JackMcCrae/AIS-SRAD-2026/FC Design/Datasheets/Processor/STM32 power scheme.png

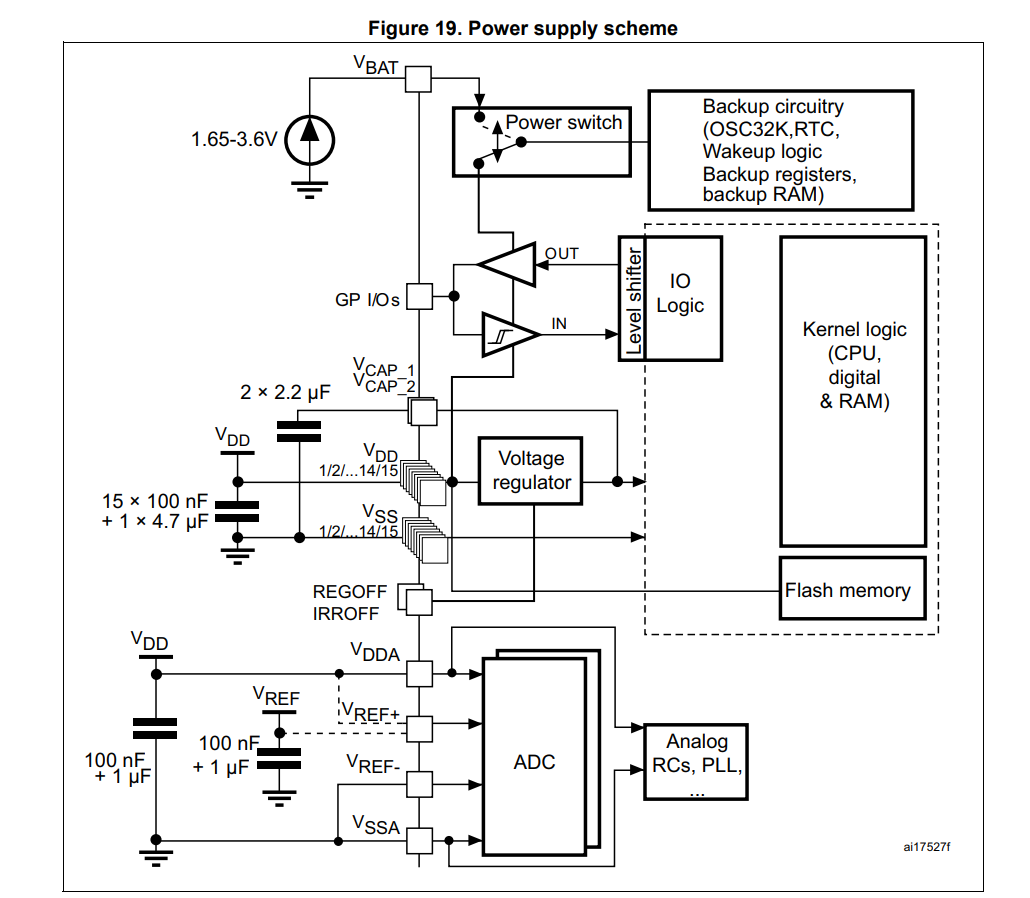
FC Design/Datasheets/Processor/STM32 power scheme.png
