JackMcCrae/AIS-SRAD-2026/FC Design/Manufacturing Files/BOM File/JLC BOM.xlsx

Component | Designator | Footprint
CY-9650 | BUZZER1 | MLT-9650
100nF | C1,C2,C4,C5,C6,C7,C8,C10,C14,C15,C16,C17,C23,C31 | GRM022C81C222KE01L
2.2uF | C18,C19 | GRM033D70J224ME01D
4.7uF | C20 | GRM033D70J224ME01D
1uF | C22,C28 | CAPC0603X33N
0603 Green 509-620mcd | LED1,LED2,LED3,LED4,LED5,LED6 | LED0603-RD
10KR | R9,R5,R3,R8,R7,R10,R11 | R_0201_0603Metric
5.1KR | R2 | R_0201_0603Metric
DMN2008LFU-7 | Q3,Q2 | DMN2008LFU7
Conn_01x08 | J6,J3 | Hirose_DF13-08P-1.25DSA_1x08_P1.25mm_Vertical
EBAA-02-C | J5,J4,J2 | EBAA02C
USB-310-B-SU | U7 | UBS-310-B-SU
STM32F205VGT | U3 | STM32F205VGT
MMBT3906-TP | Q1 | SOT95P237X125-3N
KC2520Z | U2 | Oscillator_SMD_Kyocera_KC2520Z-4Pin_2.5x2.0mm
AZ1117-3.3 | U4 | SOT-223-3_TabPin2
MS5607-02BA | U5 | LGA-8_3x5mm_P1.25mm
QMA6100P | U1 | QMA6100P
W25N01GVZEIG | U6 | W25N01GVZEIG
