JackMcCrae/AIS-SRAD-2026/FC Design/AIS IREC 2026 FC/AIS IREC 2026 FC.kicad_pcb

## KiCad design FC Design/AIS IREC 2026 FC/AIS IREC 2026 FC.kicad_pcb (2026-03-24)

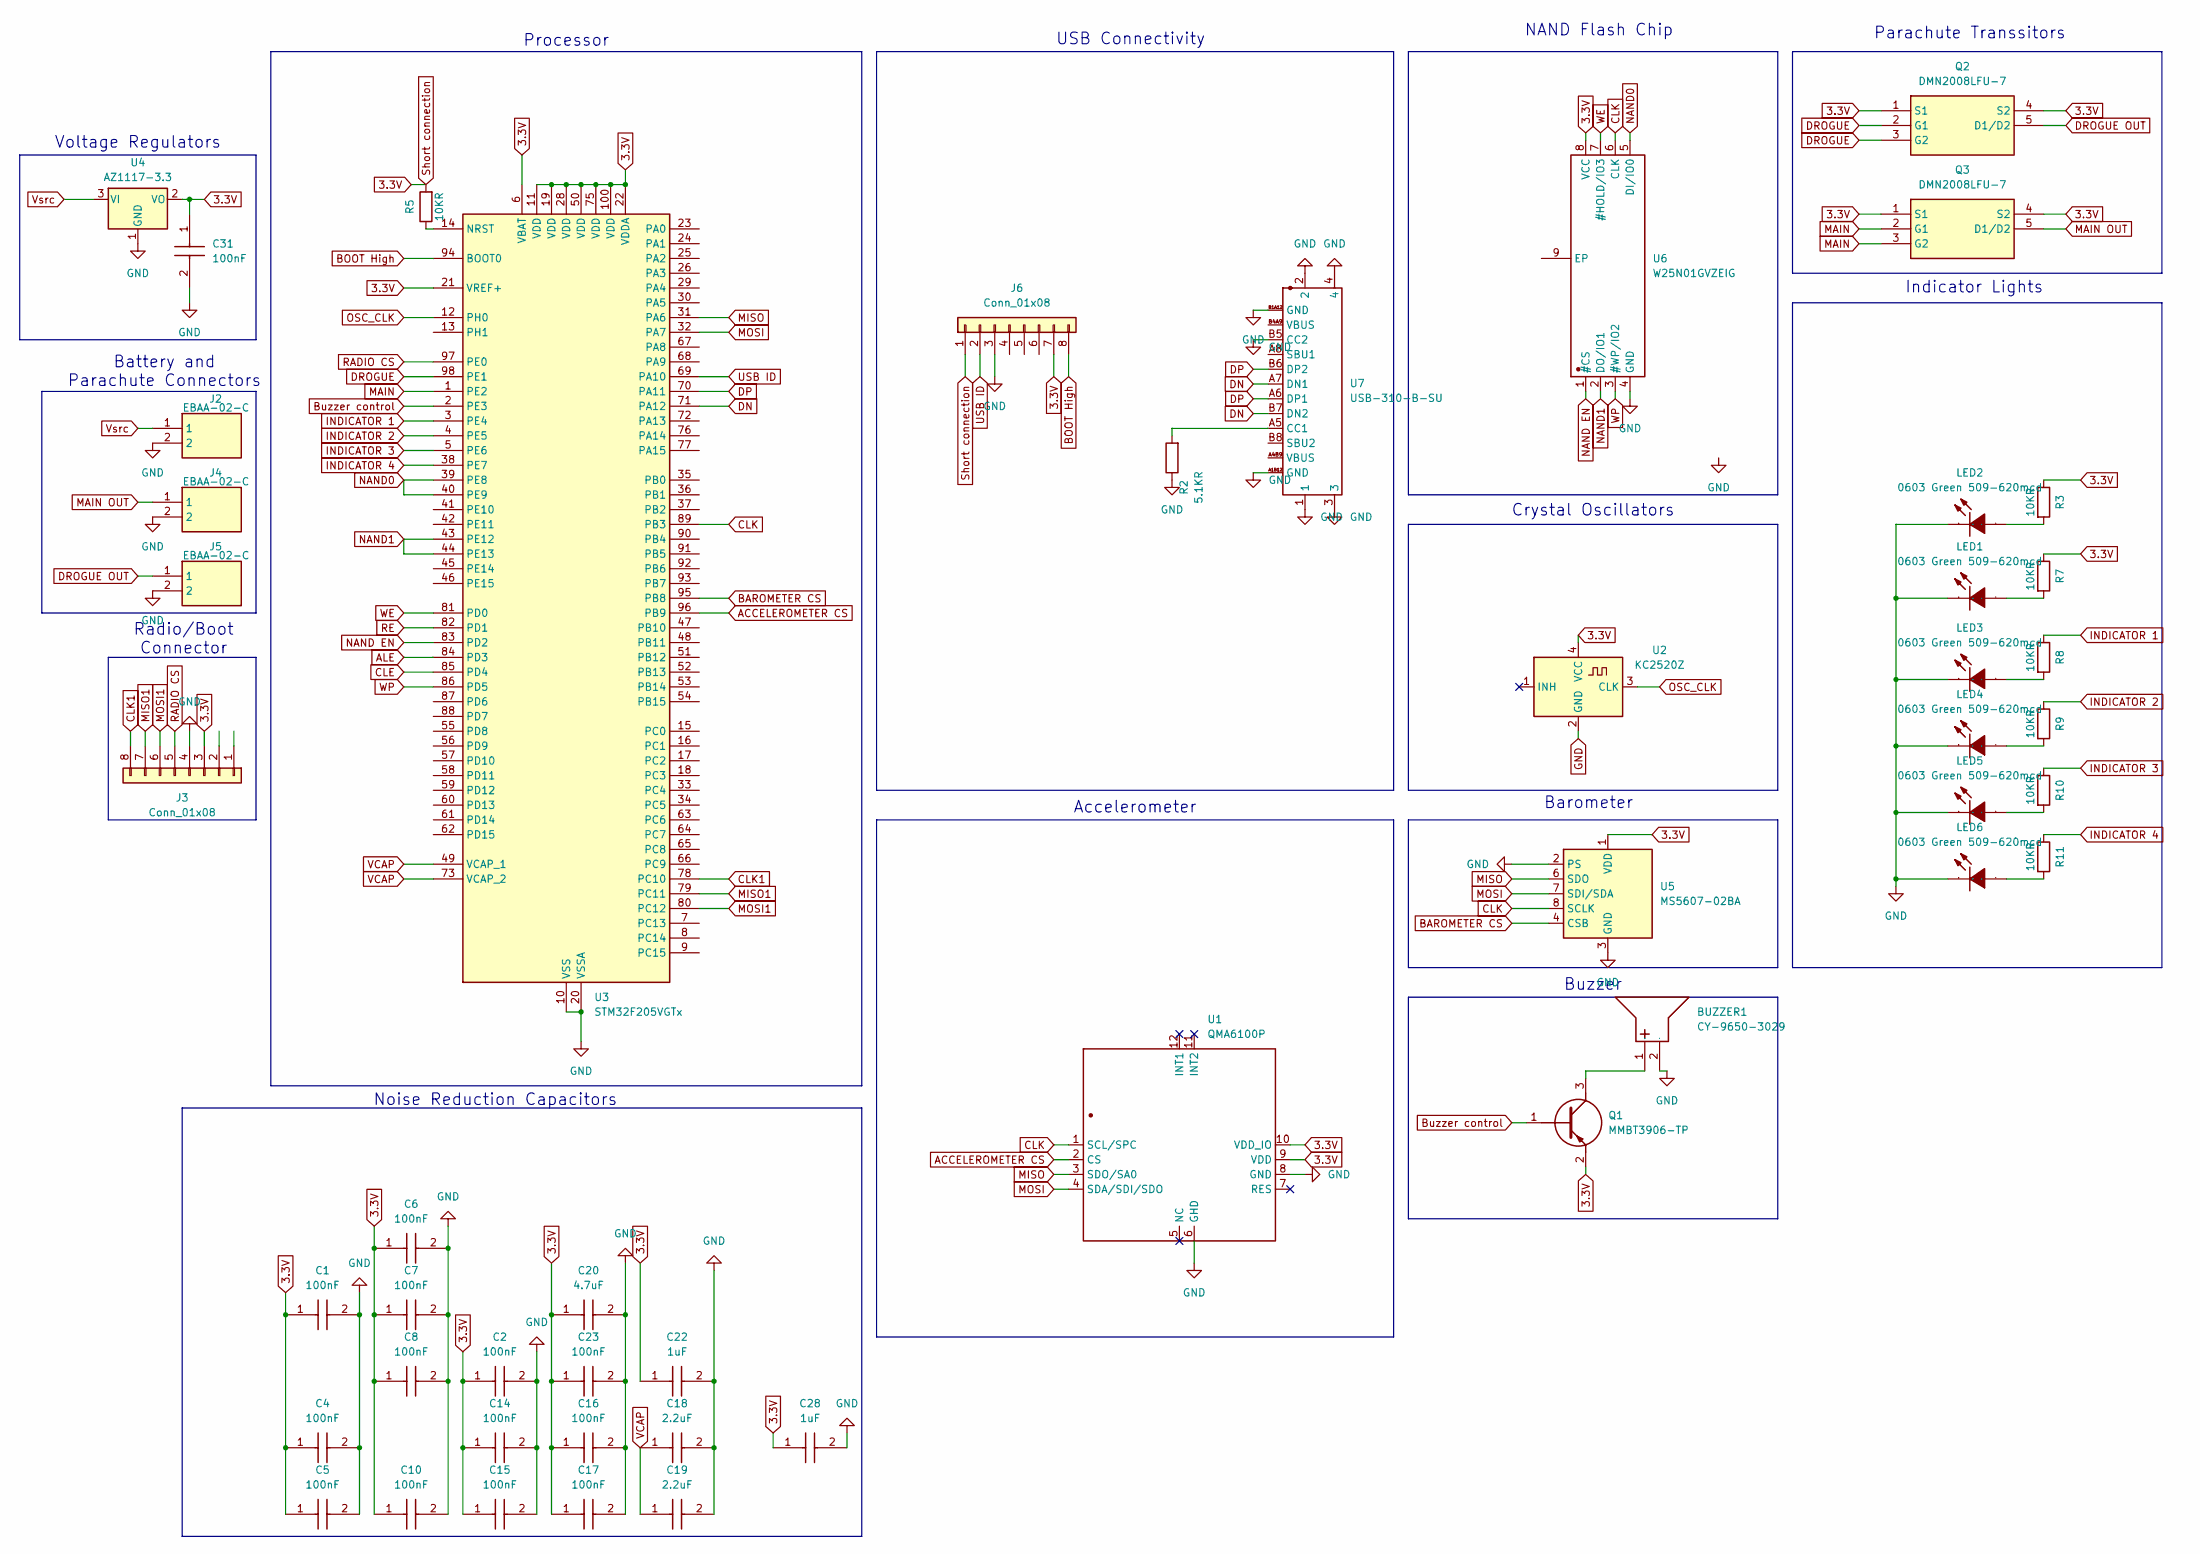
[picture p2: schematic AIS IREC 2026 FC.kicad_sch, AIS SRAD Flight Computer 2026]

Parts:
BUZZER1: CY-9650-3029; MLT-9650; Manufacturer Part Cy-9650-3029
C1, C2, C4, C5, C6, C7, C8, C10, C14, C15, C16, C17, C23, C31: 100nF; GRM022C81C222KE01L; Mouser Part Number 81-GRM022R61A104KE1L
C18, C19: 2.2uF; GRM033D70J224ME01D; Mouser Part Number 81-GRM033R61A225KE7D
C20: 4.7uF; GRM033D70J224ME01D; Mouser Part Number 81-GRM035R60J475ME5D
C22, C28: 1uF; CAPC0603X33N; Mouser Part Number 81-GRT033R60J105ME3D
J2, J4, J5: EBAA-02-C; EBAA02C; Mouser Part Number 737-EBAA-02-C
J3, J6: Conn_01x08; Hirose_DF13-08P-1.25DSA_1x08_P1.25mm_Vertical
LED1, LED2, LED3, LED4, LED5, LED6: 0603 Green 509-620mcd; LED0603-RD; Manufacturer Part KT-0603G
Q1: MMBT3906-TP; SOT95P237X125-3N; Mouser Part Number 833-MMBT3906-TP
Q2, Q3: DMN2008LFU-7; DMN2008LFU7; Mouser Part Number 621-DMN2008LFU-7
R2: 5.1KR; R_0201_0603Metric
R3, R5, R7, R8, R9, R10, R11: 10KR; R_0201_0603Metric
U1: QMA6100P; MR ACCELEROMETER; Manufacturer Part QMA6100P
U2: KC2520Z; Oscillator_SMD_Kyocera_KC2520Z-4Pin_2.5x2.0mm
U3: STM32F205VGTx; LQFP-100_14x14mm_P0.5mm
U4: AZ1117-3.3; SOT-223-3_TabPin2
U5: MS5607-02BA; LGA-8_3x5mm_P1.25mm
U6: W25N01GVZEIG; NAND FLASH; Manufacturer Part W25N01GVZEIG
U7: USB-310-B-SU; USB 310F B; Manufacturer Part USB-310-B-SU

Connections:
3.3V: C1.1, C2.1, C4.1, C5.1, C6.1, C7.1, C8.1, C10.1, C14.1, C15.1, C16.1, C17.1, C20.1, C22.1, C23.1, C28.1, C31.1, J3.3, J6.1, J6.7, Q1.2 (E), Q2.1 (S1), Q2.4 (S2), Q3.1 (S1), Q3.4 (S2), R3.1, R5.2, R7.1, U1.9 (VDD), U1.10 (VDD_IO), U2.4 (VCC), U3.6 (VBAT), U3.11 (VDD), U3.19 (VDD), U3.21 (VREF+), U3.22 (VDDA), U3.28 (VDD), U3.50 (VDD), U3.75 (VDD), U3.100 (VDD), U4.2 (VO), U5.1 (VDD), U6.8 (VCC)
ACCELEROMETER CS: U1.2 (CS), U3.96 (PB9)
ALE: U3.84 (PD3)
BAROMETER CS: U3.95 (PB8), U5.4 (CSB), U5.5 (CSB)
BOOT High: J6.8, U3.94 (BOOT0)
Buzzer control: Q1.1 (B), U3.2 (PE3)
CLE: U3.85 (PD4)
CLK: U1.1 (SCL/SPC), U3.89 (PB3), U5.8 (SCLK), U6.6 (CLK)
CLK1: J3.8, U3.78 (PC10)
DN: U3.71 (PA12), U7.A7 (DN1), U7.B7 (DN2)
DP: U3.70 (PA11), U7.A6 (DP1), U7.B6 (DP2)
DROGUE: Q2.2 (G1), Q2.3 (G2), U3.98 (PE1)
DROGUE OUT: J5.1, Q2.5 (D1/D2)
GND: BUZZER1.2 (-), C1.2, C2.2, C4.2, C5.2, C6.2, C7.2, C8.2, C10.2, C14.2, C15.2, C16.2, C17.2, C18.2, C19.2, C20.2, C22.2, C23.2, C28.2, C31.2, J2.2, J3.4, J4.2, J5.2, J6.3, LED1.1 (K), LED2.1 (K), LED3.1 (K), LED4.1 (K), LED5.1 (K), LED6.1 (K), R2.1, U1.6 (GHD), U1.8 (GND), U2.2 (GND), U3.10 (VSS), U3.20 (VSSA), U3.27 (VSS), U3.74 (VSS), U4.1 (GND), U5.2 (PS), U5.3 (GND), U6.4 (GND), U7.1, U7.2, U7.3, U7.4, U7.A1B12 (GND), U7.B1A12 (GND), U7.B5 (CC2)
INDICATOR 1: R8.1, U3.3 (PE4)
INDICATOR 2: R9.1, U3.4 (PE5)
INDICATOR 3: R10.1, U3.5 (PE6)
INDICATOR 4: R11.1, U3.38 (PE7)
MAIN: Q3.2 (G1), Q3.3 (G2), U3.1 (PE2)
MAIN OUT: J4.1, Q3.5 (D1/D2)
MISO: U1.3 (SDO/SA0), U3.31 (PA6), U5.6 (SDO)
MISO1: J3.7, U3.79 (PC11)
MOSI: U1.4 (SDA/SDI/SDO), U3.32 (PA7), U5.7 (SDI/SDA)
MOSI1: J3.6, U3.80 (PC12)
NAND0: U3.39 (PE8), U3.40 (PE9), U6.5 (DI/IO0)
NAND1: U3.43 (PE12), U3.44 (PE13), U6.2 (DO/IO1)
NAND EN: U3.83 (PD2), U6.1 (#CS)
unnamed: BUZZER1.1 (+), Q1.3 (C)
unnamed: LED1.2 (A), R7.2
unnamed: LED2.2 (A), R3.2
unnamed: LED3.2 (A), R8.2
unnamed: LED4.2 (A), R9.2
unnamed: LED5.2 (A), R10.2
unnamed: LED6.2 (A), R11.2
unnamed: R5.1, U3.14 (NRST)
unnamed: R2.2, U7.A5 (CC1)
OSC_CLK: U2.3 (CLK), U3.12 (PH0)
RADIO CS: J3.5, U3.97 (PE0)
RE: U3.82 (PD1)
USB ID: J6.2, U3.69 (PA10)
VCAP: C18.1, C19.1, U3.49 (VCAP_1), U3.73 (VCAP_2)
Vsrc: J2.1, U4.3 (VI)
WE: U3.81 (PD0), U6.7 (#HOLD/IO3)
WP: U3.86 (PD5), U6.3 (#WP/IO2)

Notes on the sheet:
Processor
Indicator Lights
Voltage Regulators
USB Connectivity
Battery and Parachute Connectors
Crystal Oscillators
Barometer
Noise Reduction Capacitors
Radio/Boot Connector
NAND Flash Chip
Buzzer
Accelerometer
Parachute Transsitors

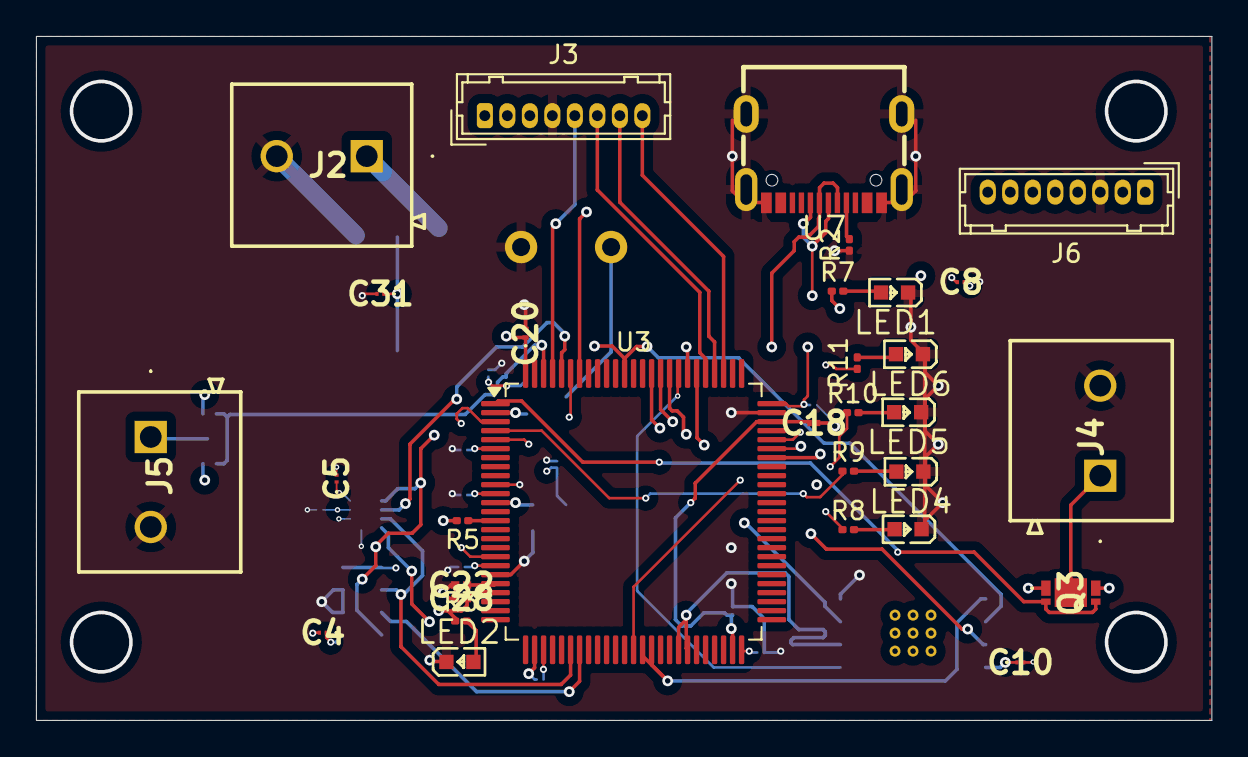
[picture p3: board AIS IREC 2026 FC.kicad_pcb from above]

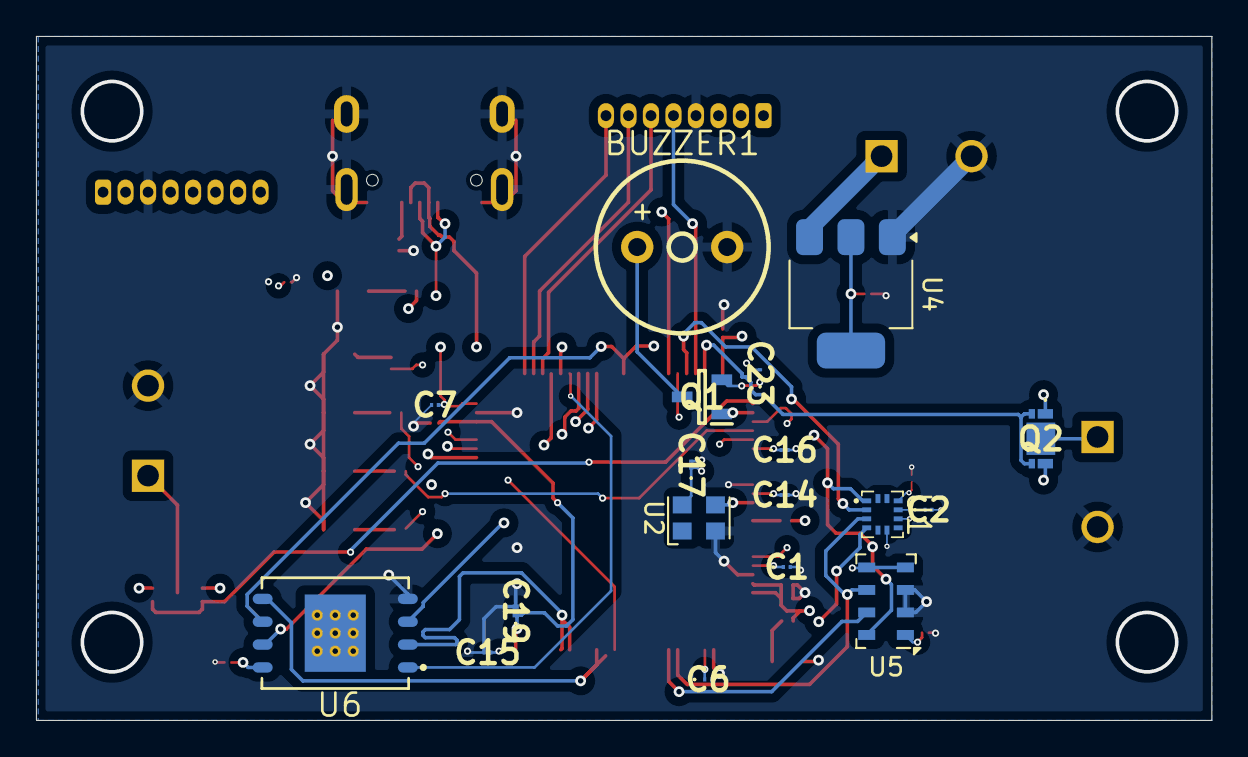
[picture p4: board AIS IREC 2026 FC.kicad_pcb from below]

Board: 4 copper layers, 65.3 x 38.0 mm, 49 parts (18 on the bottom side), 41 nets.
