JackMcCrae/AIS-SRAD-2026/Nevis predicted flight larger time step.CSV

Time (sec) | Stage | Stage Time (sec) | Mach Number | Angle of Attack (deg) | CD | CL | Thrust (lb) | Weight (lb) | Drag (lb) | Lift (lb) | CG (in) | CP (in) | Stability Margin (cal) | Accel (ft/sec^2) | Accel-V (ft/sec^2) | Accel-H (ft/sec^2) | Velocity (ft/sec) | Vel-V (ft/sec) | Vel-H (ft/sec) | Pitch Attitude (deg) | Flight Path Angle (deg) | Altitude (ft) | Distance (ft)
0 | S | 0 | 0 | 0 | 0 | 0 | 0 | 83.54 | 0 | 0 | 82.41 | 96.40492 | 2.648797 | 0 | 0 | 0 | 0 | 0 | 0 | 86 | 86 | 0 | 0 | 0 | 0
0.09999999 | S | 0.09999999 | 0.04003043 | 0 | 0.4617271 | 0 | 1516.504 | 83.09644 | 0.1345467 | 0 | 82.22182 | 96.40492 | 2.684415 | 555.0298822 | 553.5167731 | 40.95548825 | 51.32511248 | 44.11564 | 3.287351 | 86 | 86 | 1.759382 | 0.1321398 | 13.44644707 | 13.44644707
0.2 | S | 0.2 | 0.08457711 | 0 | 0.434528 | 0 | 1484.493 | 82.43188 | 0.565088 | 0 | 82.03362 | 96.40492 | 2.720033 | 547.1012076 | 545.6073468 | 40.40240731 | 103.4117003 | 98.87753 | 7.341658 | 86 | 86 | 8.917109 | 0.6641544 | 30.13787114 | 30.13787114
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
