JackMcCrae/AIS-SRAD-2026/Software/AIS SRAD 2026 V2/Core/Src/main.c

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
/* Includes ------------------------------------------------------------------*/
#include "main.h"

/* USER CODE BEGIN Includes */
#include <math.h>
/* USER CODE END Includes */

SPI_HandleTypeDef hspi1;
SPI_HandleTypeDef hspi3;

TIM_HandleTypeDef htim6;

PCD_HandleTypeDef hpcd_USB_OTG_FS;

void SystemClock_Config(void);
static void MX_GPIO_Init(void);
static void MX_SPI1_Init(void);
static void MX_SPI3_Init(void);
static void MX_USB_OTG_FS_PCD_Init(void);
static void MX_TIM6_Init(void);
/* USER CODE BEGIN PFP */
extern void flight_main(void);
/* USER CODE END PFP */

/* USER CODE BEGIN 0 */
#define ADXL314_CS_PORT GPIOB
#define ADXL314_CS_PIN  GPIO_PIN_9

#define ADXL314_DEVID       0x00
#define ADXL314_BW_RATE     0x2C
#define ADXL314_POWER_CTL   0x2D
#define ADXL314_DATA_FORMAT 0x31
#define ADXL314_DATAX0      0x32

#define ADXL314_READ        0x80
#define ADXL314_MULTI_BYTE  0x40

#define ADXL314_SCALE_G_PER_LSB 0.04883f

static void ADXL314_CS_Low(void) {
    HAL_GPIO_WritePin(GPIOB, GPIO_PIN_8, GPIO_PIN_SET);
    HAL_GPIO_WritePin(ADXL314_CS_PORT, ADXL314_CS_PIN, GPIO_PIN_RESET);
}

static void ADXL314_CS_High(void) {
    HAL_GPIO_WritePin(ADXL314_CS_PORT, ADXL314_CS_PIN, GPIO_PIN_SET);
}

static uint8_t ADXL314_ReadReg(uint8_t regAddr) {
    uint8_t txData[2];
    uint8_t rxData[2] = {0};

    txData[0] = regAddr | ADXL314_READ;
    txData[1] = 0x00;

    ADXL314_CS_Low();
    HAL_SPI_TransmitReceive(&hspi1, txData, rxData, 2, 10);
    ADXL314_CS_High();

    return rxData[1];
}

static void ADXL314_WriteReg(uint8_t regAddr, uint8_t data) {
    uint8_t txData[2];

    txData[0] = regAddr & 0x7F;
    txData[1] = data;

    ADXL314_CS_Low();
    HAL_SPI_Transmit(&hspi1, txData, 2, 10);
    ADXL314_CS_High();
}

uint8_t ADXL314_Init(void) {
    ADXL314_CS_High();
    HAL_Delay(5);

    uint8_t id = ADXL314_ReadReg(ADXL314_DEVID);

    if (id != 0xE5) {
        return 0;
    }

    ADXL314_WriteReg(ADXL314_POWER_CTL, 0x00);

    ADXL314_WriteReg(ADXL314_BW_RATE, 0x0A);

    ADXL314_WriteReg(ADXL314_DATA_FORMAT, 0x0B);

    ADXL314_WriteReg(ADXL314_POWER_CTL, 0x08);

    HAL_Delay(5);

    return 1;
}

uint8_t ADXL314_ReadXYZ(ADXL314_Data *data) {
    uint8_t tx[7] = {0};
    uint8_t rx[7] = {0};

    tx[0] = ADXL314_READ | ADXL314_MULTI_BYTE | ADXL314_DATAX0;

    ADXL314_CS_Low();

    HAL_StatusTypeDef status =
        HAL_SPI_TransmitReceive(&hspi1, tx, rx, 7, 10);

    ADXL314_CS_High();

    if (status != HAL_OK) {
        return 0;
    }

    data->x_raw = (int16_t)((rx[2] << 8) | rx[1]);
    data->y_raw = (int16_t)((rx[4] << 8) | rx[3]);
    data->z_raw = (int16_t)((rx[6] << 8) | rx[5]);

    data->x_g = data->x_raw * ADXL314_SCALE_G_PER_LSB;
    data->y_g = data->y_raw * ADXL314_SCALE_G_PER_LSB;
    data->z_g = data->z_raw * ADXL314_SCALE_G_PER_LSB;

    data->magnitude_g = sqrtf(
        data->x_g * data->x_g +
        data->y_g * data->y_g +
        data->z_g * data->z_g
    );

    return 1;
}
#define MS5607_CS_PORT GPIOB
#define MS5607_CS_PIN  GPIO_PIN_8

#define MS5607_CMD_RESET      0x1E
#define MS5607_CMD_ADC_READ   0x00

#define MS5607_CMD_CONV_D1_4096 0x48
#define MS5607_CMD_CONV_D2_4096 0x58

#define MS5607_CMD_PROM_READ  0xA0

static uint16_t ms5607_prom[8];

static void MS5607_CS_Low(void) {
    HAL_GPIO_WritePin(GPIOB, GPIO_PIN_9, GPIO_PIN_SET);

    HAL_GPIO_WritePin(MS5607_CS_PORT, MS5607_CS_PIN, GPIO_PIN_RESET);
}

static void MS5607_CS_High(void) {
    HAL_GPIO_WritePin(MS5607_CS_PORT, MS5607_CS_PIN, GPIO_PIN_SET);
}

static void MS5607_WriteCommand(uint8_t cmd) {
    MS5607_CS_Low();
    HAL_SPI_Transmit(&hspi1, &cmd, 1, 100);
    MS5607_CS_High();
}

static uint8_t MS5607_SPI_Transfer(uint8_t tx) {
    uint8_t rx = 0;
    HAL_SPI_TransmitReceive(&hspi1, &tx, &rx, 1, 100);
    return rx;
}

static uint16_t MS5607_ReadPROM(uint8_t index) {
    uint8_t cmd = MS5607_CMD_PROM_READ + (index * 2);
    uint8_t msb;
    uint8_t lsb;

    MS5607_CS_Low();

    HAL_SPI_Transmit(&hspi1, &cmd, 1, 100);

    msb = MS5607_SPI_Transfer(0x00);
    lsb = MS5607_SPI_Transfer(0x00);

    MS5607_CS_High();

    return ((uint16_t)msb << 8) | lsb;
}

static uint32_t MS5607_ReadADC(void) {
    uint8_t cmd = MS5607_CMD_ADC_READ;
    uint8_t b1;
    uint8_t b2;
    uint8_t b3;

    MS5607_CS_Low();

    HAL_SPI_Transmit(&hspi1, &cmd, 1, 100);

    b1 = MS5607_SPI_Transfer(0x00);
    b2 = MS5607_SPI_Transfer(0x00);
    b3 = MS5607_SPI_Transfer(0x00);

    MS5607_CS_High();

    return ((uint32_t)b1 << 16) | ((uint32_t)b2 << 8) | b3;
}

static uint32_t MS5607_ConvertAndRead(uint8_t command) {
    MS5607_WriteCommand(command);

    HAL_Delay(10);

    return MS5607_ReadADC();
}

uint8_t MS5607_Init(void) {
    MS5607_CS_High();
    HAL_Delay(5);

    MS5607_WriteCommand(MS5607_CMD_RESET);

    HAL_Delay(5);

    for (uint8_t i = 0; i < 8; i++) {
        ms5607_prom[i] = MS5607_ReadPROM(i);
    }

    for (uint8_t i = 1; i <= 6; i++) {
        if (ms5607_prom[i] == 0x0000 || ms5607_prom[i] == 0xFFFF) {
            return 0;
        }
    }

    return 1;
}

uint8_t MS5607_Read(MS5607_Data *data) {
    uint32_t D1;
    uint32_t D2;

    int32_t dT;
    int32_t TEMP;

    int64_t OFF;
    int64_t SENS;
    int64_t P64;
    int32_t P;

    D1 = MS5607_ConvertAndRead(MS5607_CMD_CONV_D1_4096);
    D2 = MS5607_ConvertAndRead(MS5607_CMD_CONV_D2_4096);

    if (D1 == 0 || D2 == 0) {
        return 0;
    }

    data->D1 = D1;
    data->D2 = D2;

    dT = (int32_t)D2 - ((int32_t)ms5607_prom[5] << 8);

    TEMP = 2000 + (int32_t)(((int64_t)dT * ms5607_prom[6]) >> 23);

    OFF = ((int64_t)ms5607_prom[2] << 17)
        + (((int64_t)ms5607_prom[4] * dT) >> 6);

    SENS = ((int64_t)ms5607_prom[1] << 16)
         + (((int64_t)ms5607_prom[3] * dT) >> 7);

    if (TEMP < 2000) {
        int64_t T2;
        int64_t OFF2;
        int64_t SENS2;
        int64_t temp_diff;

        T2 = ((int64_t)dT * dT) >> 31;

        temp_diff = TEMP - 2000;
        OFF2 = (61 * temp_diff * temp_diff) >> 4;
        SENS2 = 2 * temp_diff * temp_diff;

        if (TEMP < -1500) {
            int64_t very_low_diff = TEMP + 1500;

            OFF2 += 15 * very_low_diff * very_low_diff;
            SENS2 += 8 * very_low_diff * very_low_diff;
        }

        TEMP -= T2;
        OFF -= OFF2;
        SENS -= SENS2;
    }

    P64 = (((int64_t)D1 * SENS) >> 21) - OFF;
    P = (int32_t)(P64 >> 15);

    data->temperature_c = TEMP / 100.0f;
    data->pressure_mbar = P / 100.0f;

    data->altitude_m =
        44330.0f * (1.0f - powf(data->pressure_mbar / 1013.25f, 0.19029495f));

    return 1;
}
/* USER CODE END 0 */

/**
  * @brief  The application entry point.
  * @retval int
  */
int main(void)
{

  /* MCU Configuration--------------------------------------------------------*/

  /* Reset of all peripherals, Initializes the Flash interface and the Systick. */
  HAL_Init();

  /* Configure the system clock */
  SystemClock_Config();

  /* Initialize all configured peripherals */
  MX_GPIO_Init();
  MX_SPI1_Init();
  MX_SPI3_Init();
  MX_USB_OTG_FS_PCD_Init();
  MX_TIM6_Init();
  /* USER CODE BEGIN 2 */
  if (!ADXL314_Init()) {
    Error_Handler();
  }
  if (!MS5607_Init()) {
    Error_Handler();
  }
  flight_main();
  /* USER CODE END 2 */

  /* Infinite loop */
  /* USER CODE BEGIN WHILE */
  while (1)
  {
    /* USER CODE END WHILE */

  }
  
}

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
