JackMcCrae/AIS-SRAD-2026/Software/AIS SRAD 2026 V2/AIS SRAD 2026 V2.ioc

Mcu.UserName=STM32F205VBTx
PA10.Signal=USB_OTG_FS_ID
PA11.Signal=USB_OTG_FS_DM
PA12.Signal=USB_OTG_FS_DP
PA14.Signal=GPIO_Output
PA15.Signal=GPIO_Input
PA6.Signal=SPI1_MISO
PA7.Signal=SPI1_MOSI
PA8.Signal=GPIO_Output
PA9.Signal=GPIO_Input
PB14.Signal=GPIO_Output
PB15.Signal=GPIO_Input
PB3.Signal=SPI1_SCK
PB8.Signal=GPIO_Output
PB9.Signal=GPIO_Output
PC10.Signal=SPI3_SCK
PC11.Signal=SPI3_MISO
PC12.Signal=SPI3_MOSI
PC14-OSC32_IN.Signal=GPXTI14
PC8.Signal=GPIO_Output
PC9.Signal=GPIO_Input
PD0.Signal=GPXTI0
PD1.Signal=GPIO_Output
PD10.Signal=GPIO_Output
PD11.Signal=GPIO_Input
PD14.Signal=GPIO_Output
PD15.Signal=GPIO_Input
PD2.Signal=GPIO_Output
PD3.Signal=GPIO_Output
PD4.Signal=GPIO_Output
PD5.Signal=GPIO_Output
PE0.Signal=GPIO_Output
PE12.Signal=GPIO_Output
PE13.Signal=GPIO_Input
PE2.Signal=GPIO_Output
PE3.Signal=GPIO_Output
PE4.Signal=GPIO_Output
PE8.Signal=GPIO_Output
PE9.Signal=GPIO_Input
PH0-OSC_IN.Signal=RCC_OSC_IN
PH1-OSC_OUT.Signal=RCC_OSC_OUT
