JackMcCrae/AIS-SRAD-2026/(commit log)

2026-01-11 Files generated by STM32 cube IDE & pcb schematic before pcb design is started
    [AIS IREC 2026 FC.kicad_pcb, AIS IREC 2026 FC.kicad_sch]
2026-01-14 Added transistors to schematic
    [AIS IREC 2026 FC.kicad_sch]
2026-01-16 Altered FC design and setup on Cube IDE for flashing
    [AIS IREC 2026 FC.kicad_sch]
2026-01-16 Updates to wiring to help with flashing of microprocessor
    [AIS IREC 2026 FC.kicad_sch]
2026-01-16 Component placement done for pcb
    [AIS IREC 2026 FC.kicad_pcb, AIS IREC 2026 FC.kicad_sch]
2026-01-16 Updated details on pcb
    [AIS IREC 2026 FC.kicad_pcb]
2026-01-18 Updates to pcb
    [AIS IREC 2026 FC.kicad_pcb, AIS IREC 2026 FC.kicad_sch]
2026-01-21 More changes
    [AIS IREC 2026 FC.kicad_sch]
2026-01-25 Readability changes
    [AIS IREC 2026 FC.kicad_sch]
2026-01-31 added ESRA discord flight data
    [(Easy Mini 2024) PRIMARY EASYMINI 2024-06-19-serial-10090-flight-0004.csv, (Easy Mini December) 2024-12-17-serial-13491-flight-0002.csv, (Easy Mini SAC 2024) BACKUP EASY MINI 2024-06-19-serial-10107-flight-0002.csv, (Featherweight December) FthrWt04459_12-08-2024_13_26_01.csv, (Featherweight SAC 2024) FthrWt02894_06-19-2024_15_46_10.csv, (SRAD December) 110_FlightData.csv, UMD_drop_test.csv]
2026-01-31 added ras aero flight simulation
    [Nevis predicted flight.CSV]
2026-01-31 more predicted flight data
    [Nevis predicted flight larger time step.CSV]
2026-01-31 added unit conversions
    [Nevis predicted flight larger time step.CSV]
2026-02-27 Added PCB layout
    Layout is 48% smaller than AV bay was designed to hold, so no issues, space left because I'm lazy. Allows for further improvement in subsequent years.
    [AIS IREC 2026 FC.kicad_pcb]
2026-02-27 Fucking hell
    All of the routing. All of the fucking routing.
    [AIS IREC 2026 FC.kicad_pcb, AIS IREC 2026 FC.kicad_sch]
2026-03-04 Implement Kalman filter for altitude measurement
2026-03-10 PCB routing changes
    [AIS IREC 2026 FC.kicad_pcb]
2026-03-11 Changed from usb fs and hs to just usb fs, made appropriate changes
    [AIS IREC 2026 FC.kicad_pcb, AIS IREC 2026 FC.kicad_sch]
2026-03-11 Got PCB to a state where I'm happy for Logan to look at it before manufacture
    [AIS IREC 2026 FC.kicad_pcb, AIS IREC 2026 FC.kicad_sch]
2026-03-23 Generated gerber and drill files for pcb
    [AIS IREC 2026 FC-B_Cu.gbr, AIS IREC 2026 FC-B_Mask.gbr, AIS IREC 2026 FC-B_Paste.gbr, AIS IREC 2026 FC-B_Silkscreen.gbr, AIS IREC 2026 FC-Edge_Cuts.gbr, AIS IREC 2026 FC-F_Cu.gbr, AIS IREC 2026 FC-F_Mask.gbr, AIS IREC 2026 FC-F_Paste.gbr]
2026-03-24 updated gerbers, BOM and placement files + component changes based off of JLC part availability
    [AIS IREC 2026 FC-B_Cu.gbr, AIS IREC 2026 FC-B_Mask.gbr, AIS IREC 2026 FC-B_Paste.gbr, AIS IREC 2026 FC-B_Silkscreen.gbr, AIS IREC 2026 FC-Edge_Cuts.gbr, AIS IREC 2026 FC-F_Cu.gbr, AIS IREC 2026 FC-F_Mask.gbr, AIS IREC 2026 FC-F_Paste.gbr]
2026-03-25 Further PCB changes. Mainly BOM, gerbers and PLC
    [AIS IREC 2026 FC-all-pos example.csv]
2026-05-22 Intergrated NAND flash into flight_main
    As well as improvements in kalman filter, but not done yet
2026-05-22 Accelerometer & Barometer
